Kapilmeet/AIoT-Cavitation-Detection-and-Adaptive-Control/Dashboard/fft_plot.png

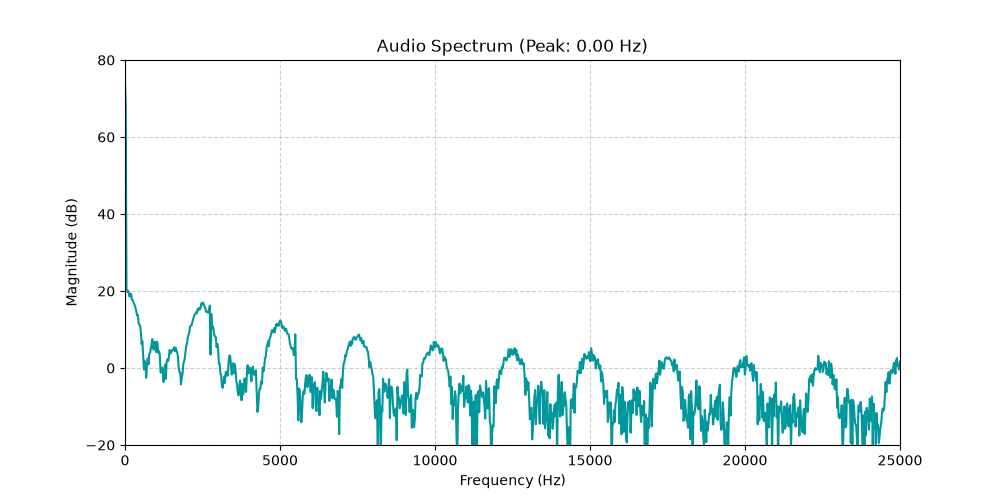
Dashboard/fft_plot.png
