Kapilmeet/AIoT-Cavitation-Detection-and-Adaptive-Control/docs/images/prototype_bench_wide.jpg

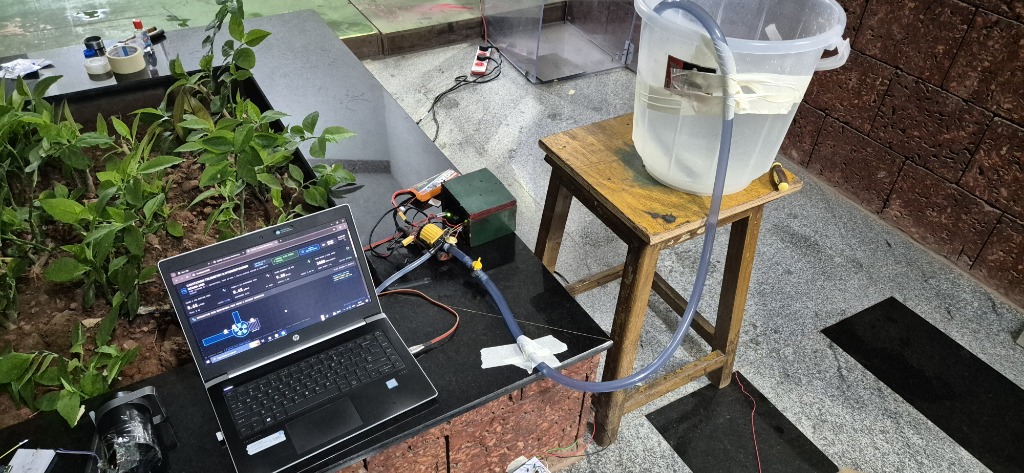
docs/images/prototype_bench_wide.jpg
