Kapilmeet/AIoT-Cavitation-Detection-and-Adaptive-Control/Firmware/Edge_Service/adc_plot.png

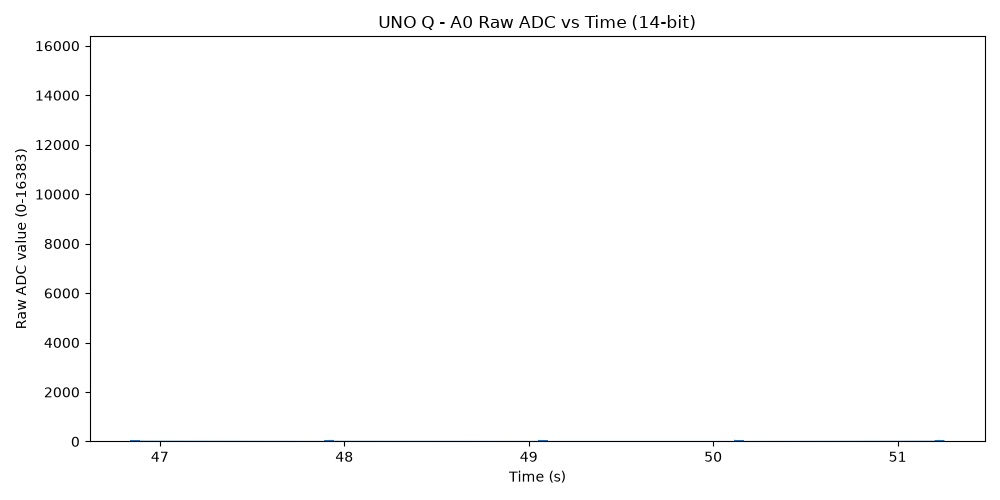
Firmware/Edge_Service/adc_plot.png
