Kapilmeet/AIoT-Cavitation-Detection-and-Adaptive-Control/Hardware/Cavitation_Schematic.kicad_sch

## KiCad design Hardware/Cavitation_Schematic.kicad_sch (2026-09-28)

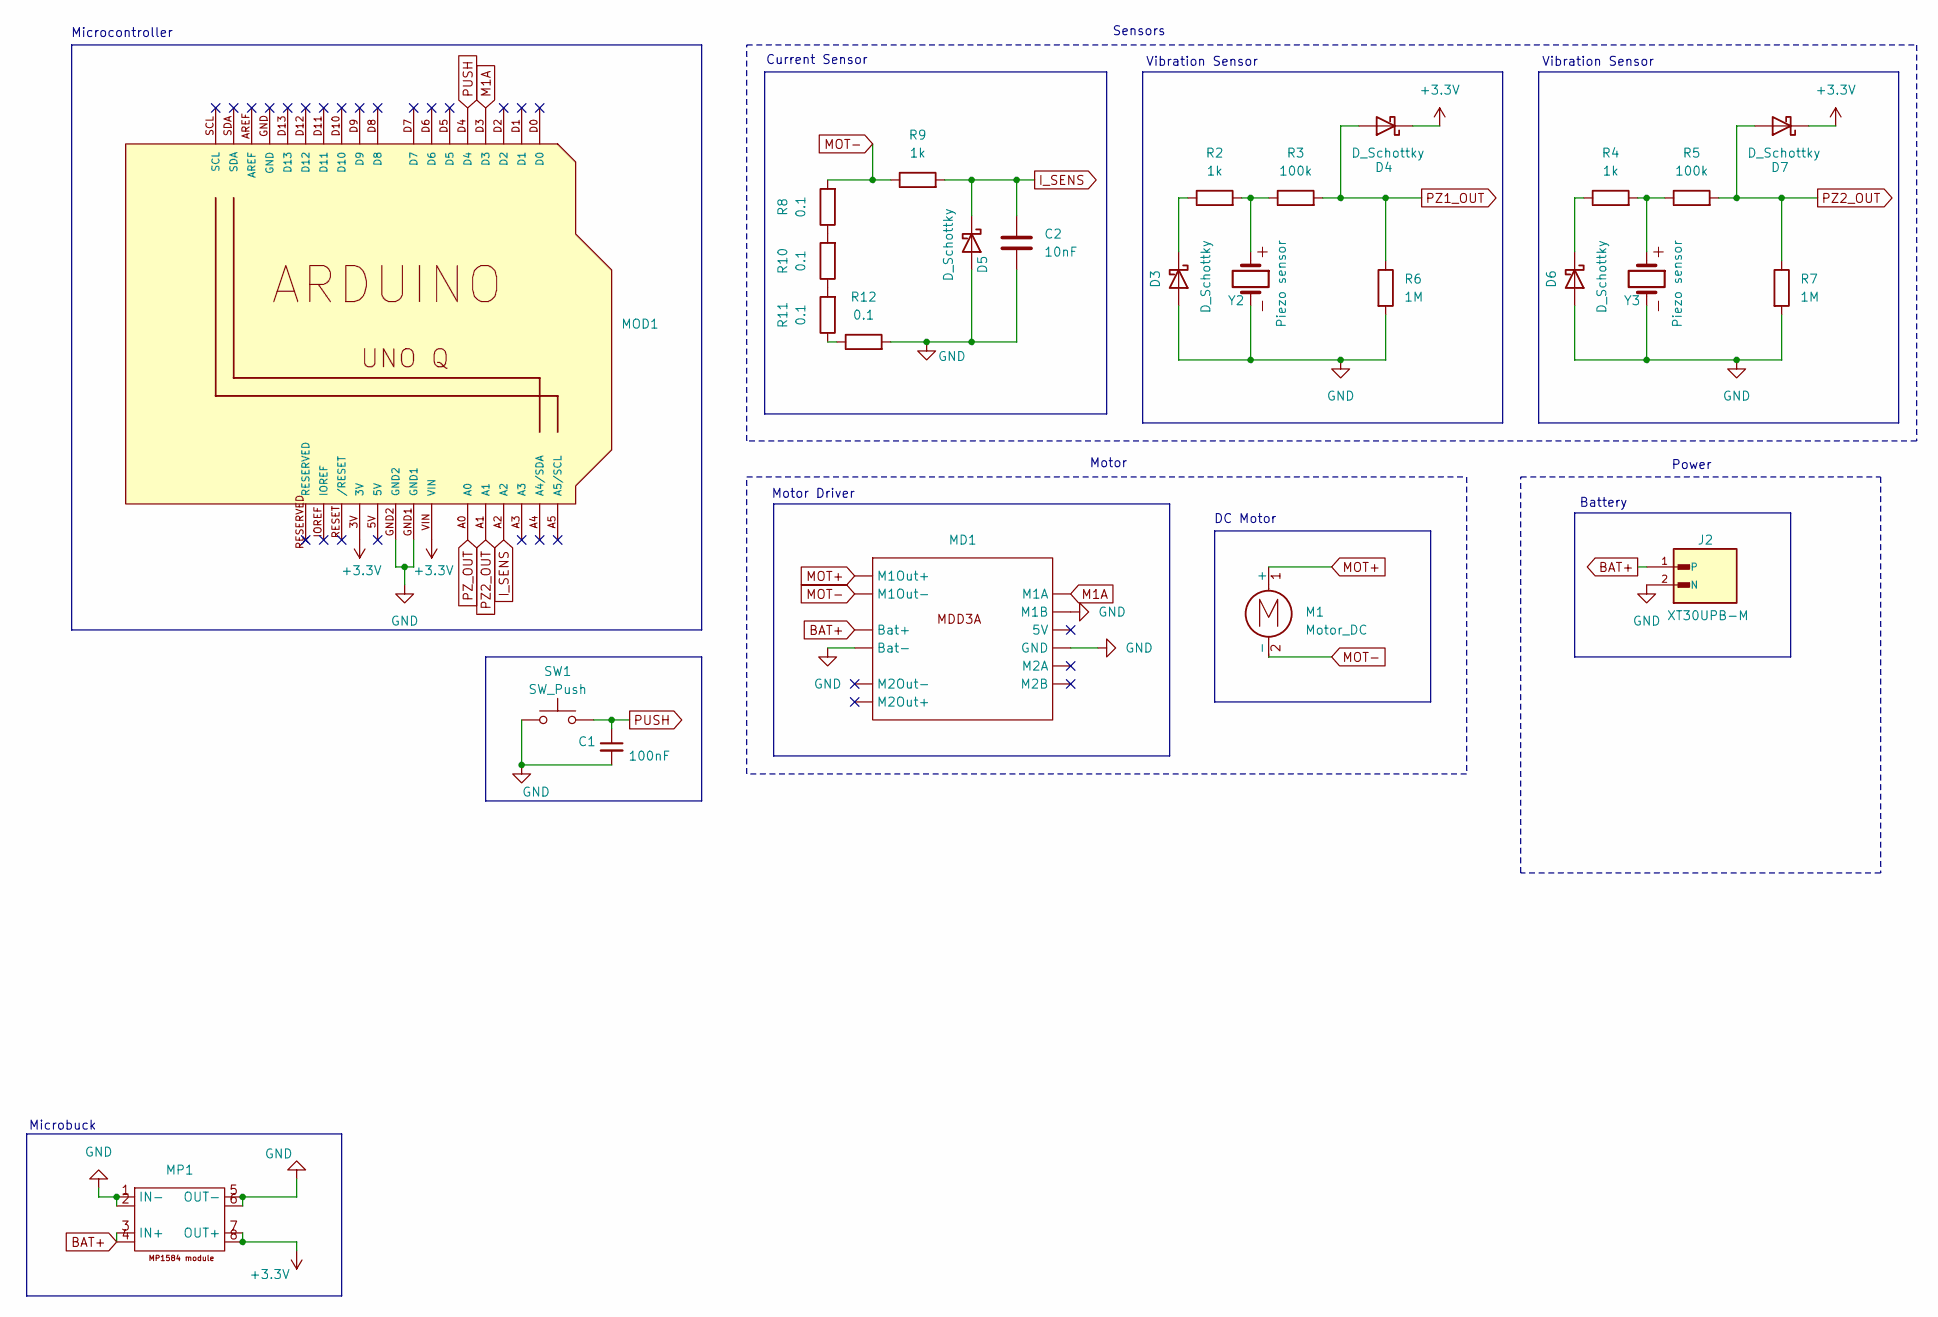
[picture p7: schematic Cavitation_Schematic.kicad_sch]

Parts:
C1: 100nF
C2: 10nF
D3, D4, D5, D6, D7: D_Schottky
J2: XT30UPB-M; AMASS_XT30UPB-M_1x02_P5.0mm_Vertical
M1: Motor_DC
MD1: (no value)
MOD1: ARDUINO-UNO-R3
MP1: MP1584_fp
R2, R4, R9: 1k
R3, R5: 100k
R6, R7: 1M
R8, R10, R11, R12: 0.1
SW1: SW_Push
Y2, Y3: Piezo sensor

Connections:
+3.3V: D4.1 (K), D7.1 (K), MOD1.3V, MOD1.VIN, MP1.7 (OUT+), MP1.8
BAT+: J2.1, MD1.9 (Bat+), MP1.3 (IN+), MP1.4
GND: C1.2, C2.2, D3.2 (A), D5.2 (A), D6.2 (A), J2.2 (N), MD1.1 (GND), MD1.6 (M1B), MD1.15 (Bat-), MOD1.GND1, MOD1.GND2, MP1.1 (IN-), MP1.2, MP1.5 (OUT-), MP1.6, R6.2, R7.2, R12.2, SW1.1, Y2.2 (-), Y3.2 (-)
I_SENS: C2.1, D5.1 (K), MOD1.A2, R9.2
M1A: MD1.7 (M1A), MOD1.D3
MOT+: M1.1 (+), MD1.13 (M1Out+)
MOT-: M1.2 (-), MD1.12 (M1Out-), R8.2, R9.1
unnamed: D3.1 (K), R2.1
unnamed: D6.1 (K), R4.1
unnamed: R2.2, R3.1, Y2.1 (+)
unnamed: R4.2, R5.1, Y3.1 (+)
unnamed: R10.1, R11.2
unnamed: R8.1, R10.2
unnamed: R11.1, R12.1
PUSH: C1.1, MOD1.D4, SW1.2
PZ1_OUT: D4.2 (A), R3.2, R6.1
PZ2_OUT: D7.2 (A), MOD1.A1, R5.2, R7.1
PZ_OUT: MOD1.A0

Notes on the sheet:
Power
Microcontroller
Battery
Sensors
Current Sensor
Motor Driver
DC Motor
Motor
Vibration Sensor
Microbuck
