Kapilmeet/AIoT-Cavitation-Detection-and-Adaptive-Control/Machine_Learning/dataset/test_audio.csv

group_id | label | severity | audio_ch1_band00 | audio_ch1_band01 | audio_ch1_band02 | audio_ch1_band03 | audio_ch1_band04 | audio_ch1_band05 | audio_ch1_band06 | audio_ch1_band07 | audio_ch1_band08 | audio_ch1_band09 | audio_ch1_band10 | audio_ch1_band11 | audio_ch1_band12 | audio_ch1_band13 | audio_ch1_band14 | audio_ch1_band15 | audio_ch1_band16 | audio_ch1_band17 | audio_ch1_band18 | audio_ch1_band19
Audio_healthy_motor50_dup | healthy | motor_50 | 10865366.02 | 25705931.98 | 27432971.72 | 32051533.61 | 28428552.37 | 17432619.32 | 17033303.09 | 11413724.55 | 9373993.258 | 9516241.655 | 4240871.357 | 1166005.352 | 1262215.458 | 247353.0641 | 715342.366 | 1333495.448 | 1578300.726 | 2994548.815 | 2046896.047 | 2118785.972
Audio_healthy_motor50_dup | healthy | motor_50 | 1113644726 | 4178290581 | 4335542594 | 3161060877 | 2319048301 | 973944053.2 | 931110072.5 | 256860204.6 | 63334043.62 | 102364322.2 | 60984742.55 | 30439270.32 | 3244173.31 | 2013471.896 | 5971493.219 | 22023542.54 | 16158554.13 | 28931275.91 | 18013404.84 | 96428448.61
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
