Kapilmeet/AIoT-Cavitation-Detection-and-Adaptive-Control/Machine_Learning/dataset/test_fused.csv

group_id | label | severity | audio_ch1_band00 | audio_ch1_band01 | audio_ch1_band02 | audio_ch1_band03 | audio_ch1_band04 | audio_ch1_band05 | audio_ch1_band06 | audio_ch1_band07 | audio_ch1_band08 | audio_ch1_band09 | audio_ch1_band10 | audio_ch1_band11 | audio_ch1_band12 | audio_ch1_band13 | audio_ch1_band14 | audio_ch1_band15 | audio_ch1_band16 | audio_ch1_band17 | audio_ch1_band18 | audio_ch1_band19 | piezo_ch1_band00 | piezo_ch1_band01 | piezo_ch1_band02 | piezo_ch1_band03 | piezo_ch1_band04 | piezo_ch1_band05 | piezo_ch1_band06 | piezo_ch1_band07 | piezo_ch1_band08 | piezo_ch1_band09 | piezo_ch1_band10 | piezo_ch1_band11 | piezo_ch1_band12 | piezo_ch1_band13 | piezo_ch1_band14 | piezo_ch1_band15 | piezo_ch1_band16 | piezo_ch1_band17 | piezo_ch1_band18 | piezo_ch1_band19 | piezo_ch2_band00 | piezo_ch2_band01 | piezo_ch2_band02 | piezo_ch2_band03 | piezo_ch2_band04 | piezo_ch2_band05 | piezo_ch2_band06 | piezo_ch2_band07 | piezo_ch2_band08 | piezo_ch2_band09 | piezo_ch2_band10 | piezo_ch2_band11 | piezo_ch2_band12 | piezo_ch2_band13 | piezo_ch2_band14 | piezo_ch2_band15 | piezo_ch2_band16
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
